Aldonza-Watt/ee310/EE310-Team16-Client-Presentation.pptx

## Water Level Detector Proof of Concept (PoC)

Presented by:
Yunbo Hu, Damian Lee, Hawon Ryu, Aldonza Watt

## Things to keep in mind for presentation (These slides to be deleted later)

Marking
- Content and Clarity
  - Project Objectives
  - Clarity of presented material
  - Support main points and finding
- Organisation
  - Appropriate use of media
  - Smooth transition between topics
  - Logical flow

## Things to keep in mind for presentation (These slides to be deleted later)

- Delivery
  - Dress code
  - Professionalism and confidence
  - Clear voice
  - Professional language (avoiding jargon)
  - Response to questions
  - Time management
    - Each person presenting for 5minutes

## Phase 1

- Designing the water level probe

## (present the probe design)

- (Flat cable, installed inside tank, dimensions

## (present the probe’s capacitance vs changes in water level)

- Capacitance vs water level graphs, maximum water level

## (discuss which of the 2 probes is more suitable for this application)

- Comparing PVC and Silicone Rubber
- Client’s requirement for accuracy

## (present probe theoretical accuracy)

- Refer to design meeting (3pF, 20% water level), provide theoretical accuracy

## Phase 2

- Transmitter

## (present the TX circuit

- Discuss the key parameters you have identified as important and explain how these parameters have been addressed (like frequency range, stability accuracy, TX to RX distance, lifespan of LED(strongly related to the current, important not to overheat it. show the characteristic of the relationship between the voltage and current of the LED and where you found it), power dissipation)

## (TX)

- Explain how you have minimized signal loss and maximized the range
  - Signal loss – where the light is spread unnecessarily

## (present the TX circuit)

- State the power of the transmitter
  - Power is important!! Client has requested recommendation
  - Battery recommendation
  - How much energy the transmitter needs to work
  - Solar panel recc

## Phase 3

- Receiver design

## (present the RX circuit)

## (RX design)

- Discuss the role of individual blocks
  - purpose of the high pass filter – to remove the DC component
    - the DC component also represents ambient light
  - role of the inverting amplifier
    - high water level to be represented by high voltage
  - and so on

## Slide 16

- State the DC Voltage Output range
  - 1.4V is our empty tank
  - 2.88V is our full tank
  - comment on non-linearity

## Slide 17

- Present a signal capture arrangement and explain how it works
  - Some sort of reflector to redirect the light towards the photodiode?

## Power

- Battery, solar power charger and other suggestions

## Slide 19

- How the battery was selected
  - Power of the transmitter, since only the TX needs battery!!
- Solar power charger – how the solar panel was selected
- Other suggestions
  - Lack of energy
  - Loss of communication
    - For the above we need to find out what is the voltage output in that case
  - How the device can be improved
