Aldonza-Watt/ee310/nz-map-of-photovoltaic-power-potential.png

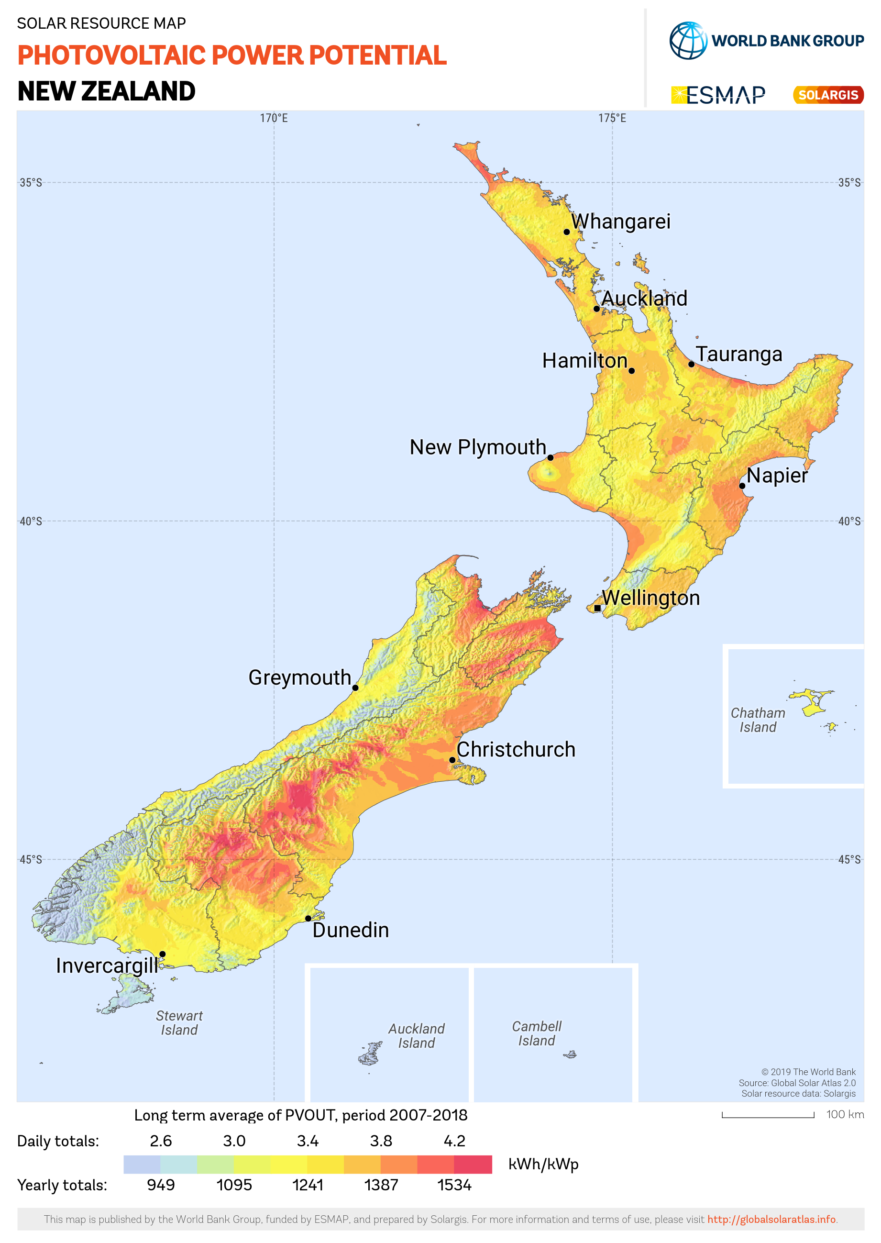
nz-map-of-photovoltaic-power-potential.png
