Aldonza-Watt/ee310/Phase2-Transmitter/Frequecy Chart.xlsx

 |  | Water Lv | Cap (pF) | Freq (kHz)
R1 | 68k | 0% | 65 | 72
R2 | 15k | 20% | 120 | 44
R3 | 27k | 40% | 175 | 32
 |  | 60% | 231 | 25
 |  | 80% | 286 | 20
 |  | 100% | 341 | 18
 |  | Water Lv | Cap (pF) | Freq (kHz)
R1 | 68k | 0% | 65 | 34
R2 | 15k | 20% | 120 | 26
R3 | 27k | 40% | 175 | 22
 |  | 60% | 231 | 18
C2 | 100pF | 80% | 286 | 16
 |  | 100% | 341 | 14
 |  | Water Lv | Cap (pF) | Freq (kHz)
R1 | 68k | 0% | 65 | 26
R2 | 15k | 20% | 120 | 22
R3 | 27k | 40% | 175 | 18
 |  | 60% | 231 | 16
C2 | 150pF | 80% | 286 | 14
 |  | 100% | 341 | 12
 |  | Water Lv | Cap (pF) | Freq (kHz)
R1 | 68k | 0% | 65 | 20
R2 | 15k | 20% | 120 | 18
R3 | 27k | 40% | 175 | 16
 |  | 60% | 231 | 14
C2 | 220pF | 80% | 286 | 12
 |  | 100% | 341 | 11
