Aldonza-Watt/ee310/Phase2-Transmitter/LTSpice/Phase-2-hardware-design.asc

C1: cap; 10p
C2: cap; 0.33µ
C3: cap; 0.01µ
C4: cap; 22p
C5: cap; 22p
C6: cap; 65p
C7: cap; 120p
C8: cap; 1p
C9: cap; 341p
Cmod: cap; 470p
D1: diode
Q1: npn2; BC547B
Q2: npn2; BC547B
R1: res; 10k
R3: res; 680
R4: res; 560
R5: res; 560
R6: res; 2.7k
R7: res; 15k
R8: res; 68k
R9: res; 15k
R10: res; 33
R11: res; 27k
U1: opamp2; TLC081
U2: opamp2; TLC081
U3: LT1086-5
U4: opamp2; TLC081
V1: voltage; 5
V2: voltage; 0
Named nets: 0, Vcc+, Vcc-, 100+20, 37+30, 1, 330+11, Vmid, Probe+, Probe-
.include TLC081.mod
.tran 0 10m 9.9m
.model BC547B NPN(IS=2.39E-14 NF=1.008 ISE=3.545E-15 NE=1.541 BF=294.3 IKF=0.1357 VAF=63.2 NR=1.004 ISC=6.272E-14 NC=1.243 BR=7.946 IKR=0.1144 VAR=25.9 RB=1 IRB=1.00E-06 RBM=1 RE=0.4683 RC=0.85 XTB=0 EG=1.11 XTI=3 CJE=1.358E-11 VJE=0.65 MJE=0.3279 TF=4.391E-10 XTF=120 VTF=2.643 ITF=0.7495 PTF=0 CJC=3.728E-12 VJC=0.3997 MJC=0.2955 XCJC=0.6193 TR=1.00E-32 CJS=0 VJS=0.75 MJS=0.333 FC=0.9579 Vceo=45 Icrating=100m mfg=Philips)
Signal Generator
LED Driver
Probe model
5V supply
Midpoint supply
