Aldonza-Watt/ee310/Phase2-Transmitter/LTSpice/Phase-2-MODDED-hardware-design.asc

C1: cap; 341p
C2: cap; 220p
R1: res; 68k
R2: res; 15k
R3: res; 27k
U1: opamp2; TLC081
U2: opamp2; TLC081
V1: voltage; 5
V2: voltage; 0
V3: voltage; 2.2
V4: voltage; 2.2
Named nets: 0, Vcc+, Vcc-, U1+, U2-, Vout
.include TLC081.mod
.tran 0 10m 9.5m
