Aldonza-Watt/ee310/Phase3-Receiver/newLTspice/RX.asc

C0: cap; 4p
C1: cap; 10p
C2: cap; 10p
C3: cap; 0.33µ
C4: cap; 0.01µ
C5: cap; 10n
C6: cap; 22p
C7: cap; 22p
C8: cap; 10p
C10: cap; 22p
C11: cap; 1n
C12: cap; 10n
C13: cap; 100p
C14: cap; 0
C15: cap; 100p
C16: cap; 0
D1: diode; 1N4148
I1-100%FULL: current; PULSE(0 1.5e-7 0 1n 1n 0.000063 0.000126)
I2-0%FULL: current; PULSE(0 1.5e-7 0 1n 1n 0.000042 0.000084)
mod: cap; 10n
R1: res; 10k
R2: res; 100k
R3: res; 680
R4: res; 560
R5: res; 560
R6: res; 10k
R7: res; 2.7k
R8: res; 10k
R9: res; 27k
R10: res; 68k
R11: res; 10k
R12: res; 2.7k
R13: res; 2.7k
R14: res; 27k
R15: res; 33k
R16: res; 2.7k
R17: res; 4.7k
R18: res; 56k
R19: res; 0
R20: res; 10k
R21: res; 10k
R22: res; 100000Meg
Rleak: res; 4e9
U1: opamp2; TLC081
U2: opamp2; TLC081
U3: LT1086-5
U4: opamp2; TLC081
U5: opamp2; TLC081
U6: opamp2; LM393A
U7: opamp2; TLC081
U8: opamp2; TLC081
V1: voltage; 5
V2: voltage; 0
Named nets: 0, Vcc+, Vcc-, U1+, J1, J3, J5, J2, J4
.include TLC081.mod
.tran 0 10m 9m
.include KA3529.txt
.include LM393A.txt
Light Detector
Signal Generator
Photodiode
Signal amplifier
Midpoint Suppply
5V Suppply
Signal conditioning
Frequency to voltage
