Aldonza-Watt/ee310/Phase1-Development-of-Probe/EE310-Team16-Phase1Result.xlsx

FEMM Simulation
Water L. | Medium | Depth (mm) | Charge | Energy | Cap | Cap | Cap. Total | Charge | Energy | Cap | Cap | Cap. Total
 |  |  | Silicone Rubber |  |  |  |  | Polyvinyl Chloride
0% | Air | 3500 | 8.84015e-11 | 8.84078e-11 | 4.420075e-11 | 4.42039e-11 | 4.42039e-11 | 1.29968e-10 | 1.29974e-10 | 6.4984e-11 | 6.4987e-11 | 6.4987e-11
 | Water | 0 | 0 | 0 | 0 | 0 |  | 0 | 0 | 0 | 0
20% | Air | 3000 | 7.757727e-11 | 7.757781e-11 | 3.8788635e-11 | 3.8788905e-11 | 6.4235455e-11 | 1.11401e-10 | 1.11406e-10 | 5.57005e-11 | 5.5703e-11 | 1.20199e-10
 | Water | 500 | 5.08932e-11 | 5.08931e-11 | 2.54466e-11 | 2.544655e-11 |  | 1.28992e-10 | 1.28992e-10 | 6.4496e-11 | 6.4496e-11
50% | Air | 2250 | 5.68295e-11 | 5.68336e-11 | 2.841475e-11 | 2.84168e-11 | 9.20333e-11 | 8.35506e-11 | 8.35548e-11 | 4.17753e-11 | 4.17774e-11 | 2.030169e-10
 | Water | 1250 | 1.27233e-10 | 1.27233e-10 | 6.36165e-11 | 6.36165e-11 |  | 3.2248e-10 | 3.22479e-10 | 1.6124e-10 | 1.612395e-10
100% | Air | 1000 | 2.52576e-11 | 2.52954e-11 | 1.26288e-11 | 1.26477e-11 | 1.398807e-10 | 3.71336e-11 | 3.71355e-11 | 1.85668e-11 | 1.856775e-11 | 3.4104725e-10
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
