Aldonza-Watt/ee310/(commit log)

2024-03-07 Uploaded a spreadsheet for documenting Phase 1.
    The spreadsheet is for documenting the data of the dielectric materials (silicone rubber and polyvinyl chloride).
    We will also state the decision for choosing the dielectric material with reasoning.
    [EE310-Team16-Phase1Result.xlsx]
2024-03-07 Moved Phase 1 result into Phase 1 folder.
    [EE310-Team16-Phase1Result.xlsx]
2024-03-07 Re-organised the data on the Phase 1 result.
    Organised the data collected from the simulation using FEMM.
    [EE310-Team16-Phase1Result.xlsx]
2024-03-07 Moved the file into the folder.
    [EE310-Team16-Phase1Result.xlsx]
2024-03-08 Update README.md
    Added the formulae used in phase 1, when finding the capacitance and observe the trend of the lines to indicate the accuracy.
2024-03-08 Create Choice-of-material.md for phase 1.
    Added the introduction of phase 1.
2024-03-12 Rename Choice-of-material.md to Phase-1-introduction.md
    Renamed it for organisation.
2024-03-12 Update README.md
    Added LTSpice as the software for simulating the circuit for phase 2 of the project.
2024-03-14 Added dataset and graph for more water level.
    We changed to 0%, 20%, 40%, 60%, 80% and 100% water level, and plot the line graph for that dataset.
    [Just for graph only, not using it actually]
    [EE310-Team16-Phase1Result.xlsx]
2024-03-14 TXv1
    first iteration of transmitter circuit & values
2024-03-14 TXv2
    updated resistor values
2024-03-14 TxV3
    Changed C to pico instead of micro.
    Messing around with the resistor values.
2024-03-18 opamp files
    readded opamp files (idk, merge be broke?)
    [TLC081.sch]
2024-03-19 TXvMODDED
    10kHz-20kHz linear frequency with C2 modification
    [Frequecy Chart.xlsx]
2024-03-21 LedDriverV1
    circuit with no values
2024-03-21 LedDriverV2
    initial values using generic BJT
2024-03-21 TXv1
    transmitter circuit - no values
2024-03-21 Included the file for 1N4007 diode in the receiver.
    Included the mod for the diode for the receiver.
2024-03-21 Changed the property of the component diode.
    Corrected the position of the diode in the Frequency to Voltage RX part of the system.
2024-03-28 Added the labels for parts of the receiver schematic.
    Labelling for clearing our minds lol.
2024-03-28 Added the LED into the phase 2 LTspice folder.
2024-03-28 Changed the model of LED in LTspice
    Changed to KA3529 model of the LED.
2024-03-28 Added the optional circuits for the buffer and offset voltage generator.
    Added the output signal conditioner for the receiver schematic.
2024-04-13 Downloaded and added a NZ map of the photovoltaic power potential map
    For reference when writing and doing poc for using solar panels.
2024-04-17 TXv2 - prototyping begin
    added midpoint supply and 5V regulator with relevant peripheral components.
2024-04-25 RX actual values on PCB
2024-04-26 Started writing the introduction and main body of the report.
    Writing the introduction and water level probe of the report.
2024-04-26 Updated the report.
    Wrote the introduction, abstract and water level probe of the report.
2024-04-26 Updated the report.
    Wrote the water level probe of report. Will keep updating tonight.
2024-04-26 Updated the technical specification.
    Recorded the Tx range and the output voltage of the transmitter failure.
2024-04-26 Updated the technical specification.
    Recorded the wavelength of the LED light, technical specification is done.
2024-04-26 Added powerpoint with instructions of format
2024-04-26 Actual RX values on our PCB
2024-05-04 beautify RX for screenshot
    [Frequecy Chart.xlsx]
